fenris0709/HA_projects/ESP32C3_Ultraschall_v4/datasheets/usbc_controller.png

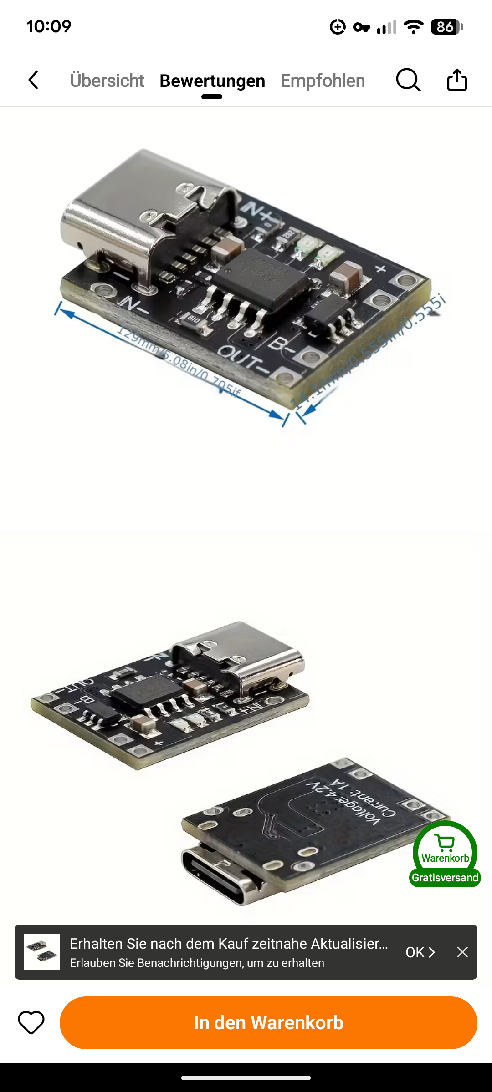
ESP32C3_Ultraschall_v4/datasheets/usbc_controller.png
