fenris0709/HA_projects/ESP32C3_Ultraschall_v4/case/preview_iso.png

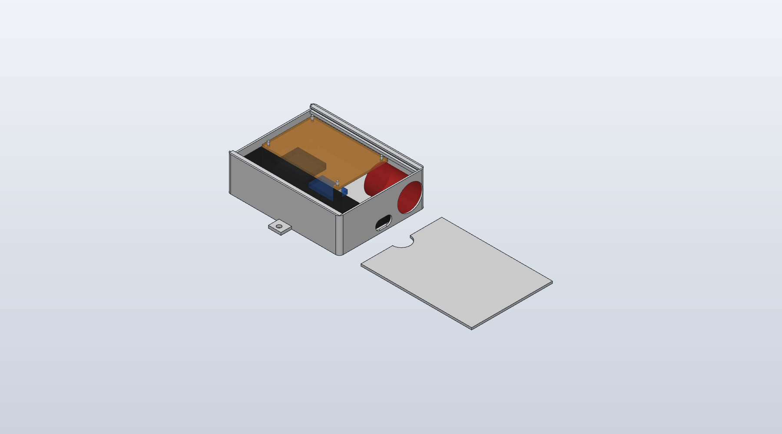
ESP32C3_Ultraschall_v4/case/preview_iso.png
