fenris0709/HA_projects/ESP32C3_Ultraschall_v4/datasheets/tof200c_dimensions.md

# TOF200C / TOF050C Breakout: Abmessungen

Quelle: `tof200c_dimensions.png` (Verkäuferbild, beschriftet "TOF050C-VL6180X"). Die 2-m-Variante TOF200C (VL53L0X) hat laut Verkäufer dieselbe Platine. Vor dem Druck am eigenen Modul nachmessen.

Ansicht von oben (Bauteilseite), Pins unten. Alle Masse in mm.

## Platine

| Mass | Wert |
|---|---|
| Gesamtbreite (Laschen) | 20.0 |
| Gesamthöhe (Lasche + Pin-Teil) | 11.0 |
| Befestigungslöcher | 2 Stück, Ø 2.0 |
| Lochabstand (Mitte–Mitte) | 14.4 |
| Abstand Lochmitte zum Platinenende | (20.0 − 14.4) / 2 = 2.8 |

Die Laschenseite ist oben abgerundet (Langloch-Form), der Pin-Teil unten ist schmaler (15.0 breit).

## Sensorfenster (schwarzes Oval)

| Mass | Wert |
|---|---|
| Länge | 9.6 |
| Höhe | 5.0 |
| Höhe inkl. Rand/Gehäuse | 6.85 |
| Lage | mittig zwischen den Befestigungslöchern, Fenster- und Lochmitte ca. 3.3 vom oberen Rand (aus dem Bild gemessen, ca. ±0.3) |

## Pins

| Mass | Wert |
|---|---|
| Anzahl | 6, einreihig |
| Raster | 2.54 |
| Breite Pin-Teil | 15.0 |
| Abstand Platinenunterkante – Pin-Mitte | ca. 1.5 (aus dem Bild geschätzt) |

Pinbelegung (typisch für VL53L0X-Module, am Silkscreen prüfen): VIN, GND, SCL, SDA, GPIO1, XSHUT.

## Aufriss (aus dem Bild nicht ersichtlich)

Platinendicke und Höhe des Sensorgehäuses über der Platine stehen nicht im Bild. Für das Gehäuse annehmen: Platine 1.0–1.2, Sensor ca. 1.8 über der Platine. Nachmessen.
