fenris0709/HA_projects/ESP32C3_Ultraschall_v4/case/preview_top.png

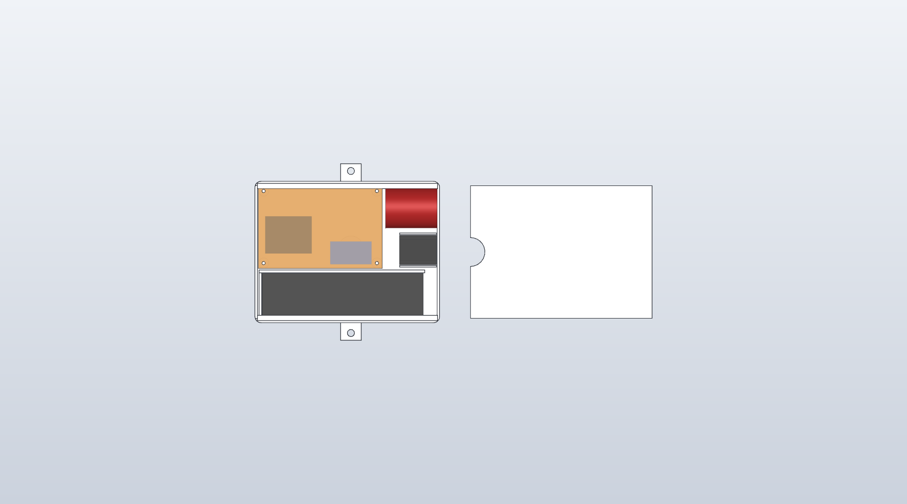
ESP32C3_Ultraschall_v4/case/preview_top.png
