fenris0709/HA_projects/ESP32C3_Ultraschall_v4/datasheets/tof200c_dimensions.png

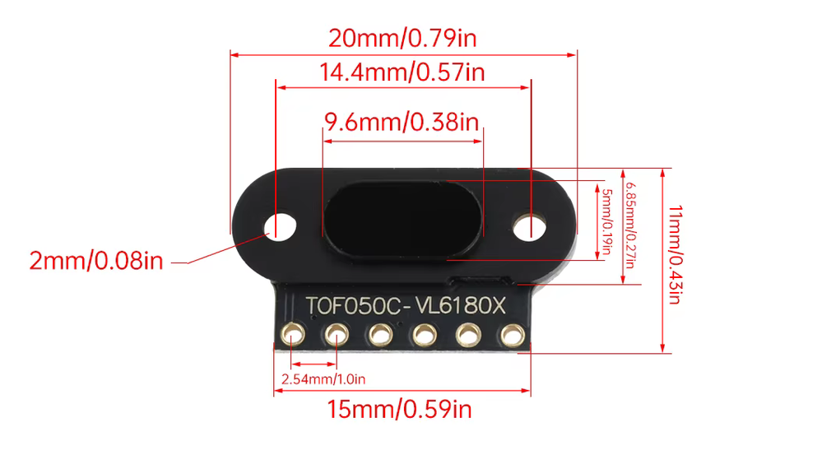
ESP32C3_Ultraschall_v4/datasheets/tof200c_dimensions.png
