fenris0709/HA_projects/ESP32C3_Ultraschall_v4/case/Deckel.stl

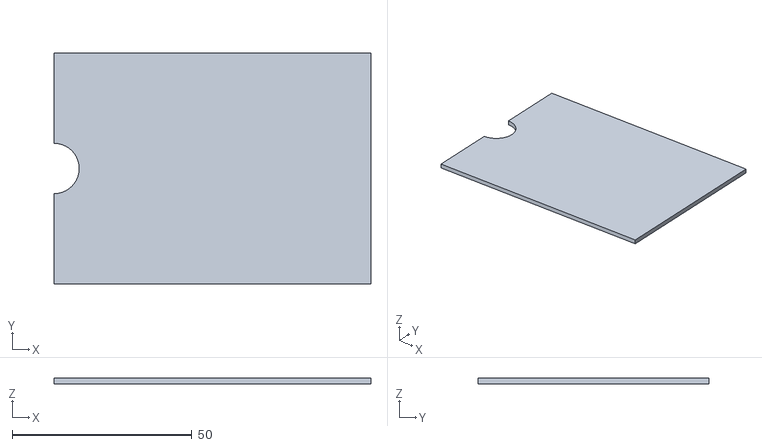
[picture p5: CAD file, 2026-11-09]
ESP32C3_Ultraschall_v4/case/Deckel.stl
88.1 x 64.3 x 1.60
