fenris0709/HA_projects/ESP32C3_Ultraschall_v4/case/Gehaeuse.stl

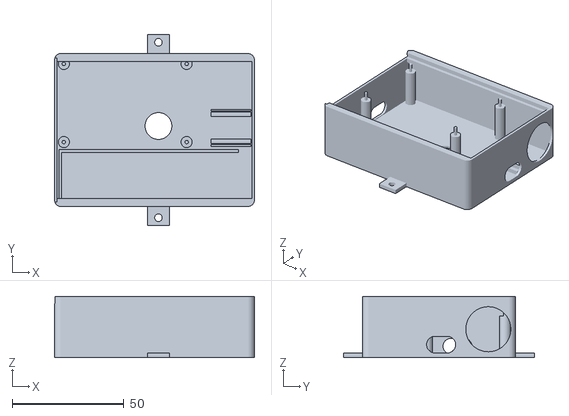
[picture p6: CAD file, 2026-11-09]
ESP32C3_Ultraschall_v4/case/Gehaeuse.stl
89.6 x 85.6 x 27.4
