fenris0709/HA_projects/ESP32C3_Ultraschall_v4/case/Sensorkappe.stl

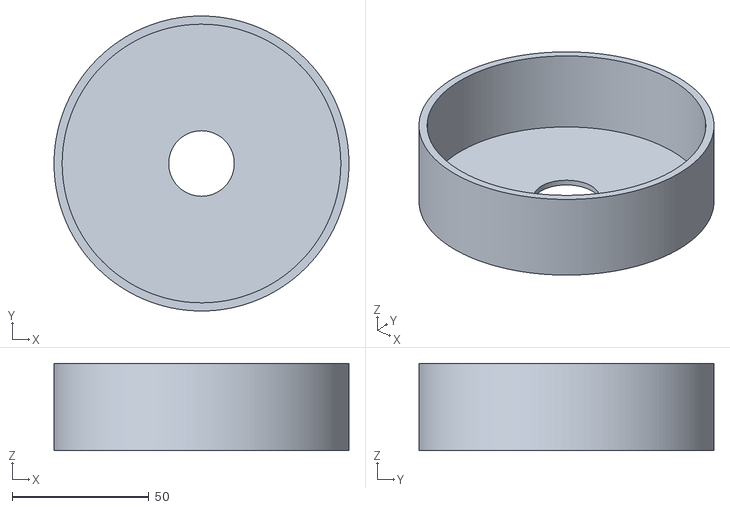
[picture p7: CAD file, 2026-10-26]
ESP32C3_Ultraschall_v4/case/Sensorkappe.stl
108.0 x 108.0 x 32.0
