fenris0709/HA_projects/ESP32C3_Ultraschall_v4/case/Gehaeuse_Passprobe.stl

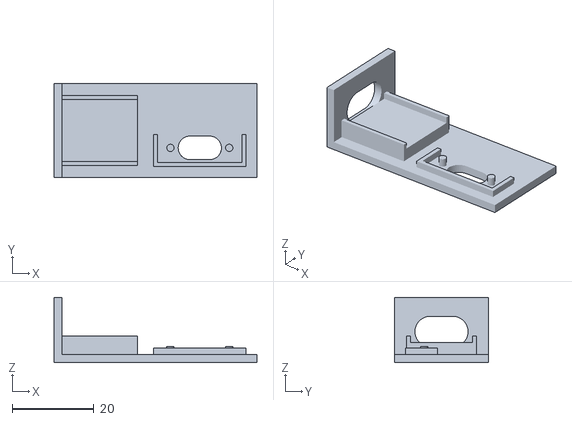
[picture p8: CAD file, 2026-10-26]
ESP32C3_Ultraschall_v4/case/Gehaeuse_Passprobe.stl
49.7 x 23.1 x 16.0
