fenris0709/HA_projects/ESP32C3_Ultraschall_v4/case/Sensorhalter.stl

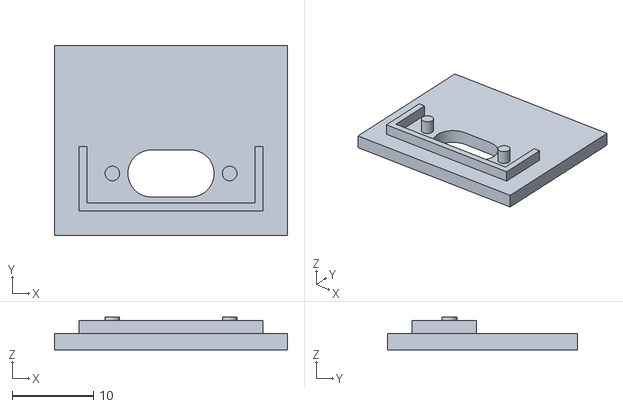
[picture p9: CAD file, 2026-10-26]
ESP32C3_Ultraschall_v4/case/Sensorhalter.stl
28.6 x 23.3 x 4.00
