fenris0709/HA_projects/ESP32C3_Ultraschall_v4/case/Gehaeuse_Unterteil.stl

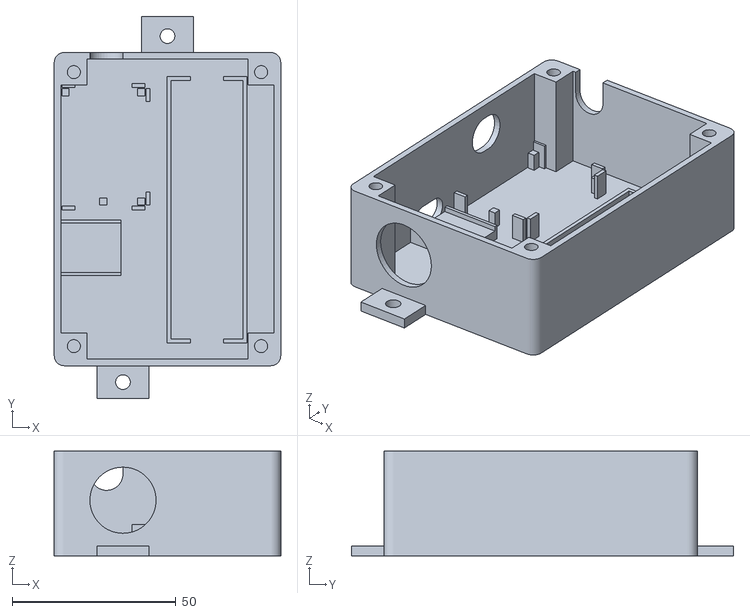
[picture p10: CAD file, 2026-10-26]
ESP32C3_Ultraschall_v4/case/Gehaeuse_Unterteil.stl
69.2 x 116.7 x 32.0
