fenris0709/HA_projects/ESP32C3_Ultraschall_v4/case/Gehaeuse_Deckel.stl

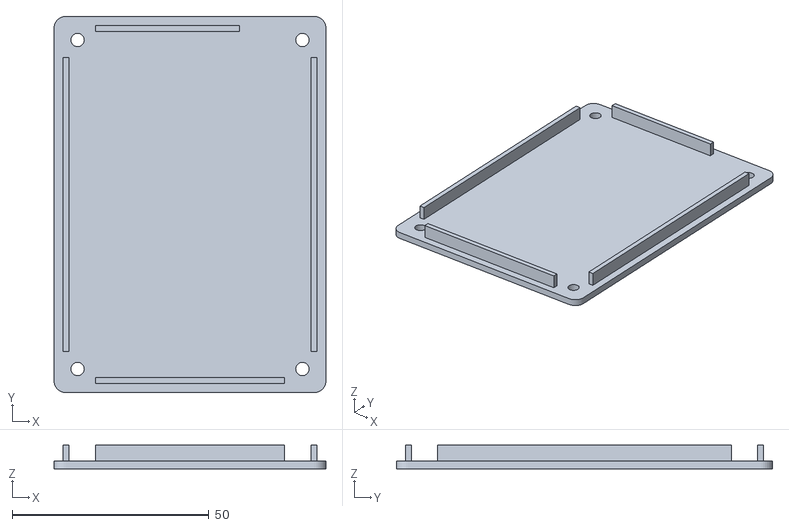
[picture p11: CAD file, 2026-10-26]
ESP32C3_Ultraschall_v4/case/Gehaeuse_Deckel.stl
69.2 x 95.7 x 6.00
