fenris0709/HA_projects/(commit log)

2026-10-20 Add ESP32-C3 ultrasonic sensor KiCad schematic and PCB layout (v4)
2026-10-20 Add perfboard prototype guide and SolidCraft enclosure
    - PROTOTYP_Lochraster.md: simplified circuit for JSN-SR04T V3.0 (3.0-5.5 V)
    without MT3608, level shifters and Q2; parts list, wiring, test plan
    - case/gen_case.py: parametric enclosure generated via solidcraft-cli
    (design, STL for base and lid, previews, interference check)
    - datasheets: JSN-SR04T V3.0 manual, TP4056 USB-C module photo
    - README_Schaltung.md: link to prototype guide
2026-10-20 Ignore KiCad automatic backup folders
2026-10-20 Simplify to stripboard prototype with MQTT firmware
    - Drop obsolete 4-layer KiCad v4 design (MT3608, MOSFET switch, level shifters)
    - Compact 10x14 stripboard layout with connectivity check (docs/gen_stripboard.py)
    - Schematic SVG generator; JSN-SR04T in low-power mode 4, always on 3V3
    - ESPHome firmware: deep sleep, MQTT discovery, battery measurement, OTA mode
    - Enclosure: clip-in stripboard holder, heat-set inserts, updated dimensions
    - README condensed to the current build
2026-10-26 Switch to VL53L0X ToF sensors with blind-cap sensor housings
    Replace the JSN-SR04T ultrasonic sensors (they picked up the tank walls)
    with two TOF200C (VL53L0X, 2 m) boards on one I2C bus, one XSHUT enable
    line per board so ESPHome can assign 0x30/0x31.
    - firmware: vl53l0x + i2c at 50 kHz for 1-2 m cables, tank values for
    163x70x200 cm tanks
    - docs: new schematic and stripboard layout (J1/J2 sensor headers)
    - case: main box now only holds ESP, TP4056, battery and switch; boards
    are hot-glued, no snap fits; new sensor blind cap (2x) that slips over
    the threaded tank neck, plus a fit-test coupon
    - datasheets: dimensions and key data as markdown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
2026-10-26 Mount ToF sensor outside the cap in a separate sensor holder
    The sensor now sits on top of the blind cap, looking down through a
    viewing hole, so the cable does not have to pass through the cap.
    The cap is a plain cup with a central hole; the board goes into a
    small printed holder (window, pegs, rims) that is hot-glued over the
    hole. Adds Sensorhalter.stl and drops the inside mount and cable notch.
2026-10-27 Control sleep time and OTA via MQTT with status feedback
    Add retained sleep_minutes topic, "Modus" and "Schlafdauer aktiv" status
    sensors, 15 samples per measurement and lower signal_rate_limit for
    better long-range readings on dark oil.
2026-11-09 Switch to one ToF sensor per tank with case mounted on the tank cap
    - Case: single printable box (1.2 mm walls, no supports) with sliding lid,
    sensor window in the floor over a drilled hole in the original tank cap,
    perfboard 60x40 on four pegs, ESP and ToF module pluggable
    - Firmware: one sensor, XSHUT kept for deep-sleep standby, device told apart
    only by the published name (sn substitution)
    - Docs: pinout, pull-ups/pull-down, circuit and rough perfboard layout in
    Markdown (no KiCad); removed the old two-sensor generators and STL files
